Nyfeu/RISC-V/clockInfo.txt

-------------------------------------
| Tool Version : Vivado v.2025.2
| Date         : Sat Sep 12 03:04:39 2026
| Host         : pop-os
| Design       : design_1
| Device       : xc7a100t-csg324-1--
-------------------------------------

For more information on clockInfo.txt clock routing debug file see https://support.xilinx.com/s/article/000035660?language=en_US
