Nyfeu/RISC-V/pkg/README.md

# 📦 VHDL Packages

Arquivos de definição global.

- `riscv_isa_pkg.vhd`: Definições do ISA RISC-V (Opcodes, Funct3, Funct7, Tipos de dados da ALU).
