Nyfeu/RISC-V/docs/main.tex

% Modelo de monografia criado para a Escola de Engenharia Mauá
% do Instituto Mauá de Tecnolgoia a partir da classe abntex2.
% Este documento só deverá ser alterado para incluir ou excluir
% elementos pré e pós textuais. Use o comentário do latex (%) caso
% deseje excluir algum elemento.

% --------------------------------------------------------------------------
% Definindo ABNTeX2
% --------------------------------------------------------------------------

\documentclass[
	12pt,				% tamanho da fonte
	openright,			% capítulos começam em pág ímpar
	twoside,			% para impressão em frente e verso. Oposto a oneside
	a4paper,			% tamanho do papel.
	chapter=TITLE,		% títulos de capítulos convertidos em letras maiúsculas
	english,			% idioma adicional para hifenização
	brazil				% o último idioma é o principal do documento
	]{abntex2}
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
\usepackage[
	inner=3cm, outer=2cm, top=3cm, 
	bottom=2cm
]{geometry}
\usepackage[final]{pdfpages}
\usepackage{longtable}
\usepackage{booktabs}
\usepackage{xltabular}
\usepackage{placeins}

\newcolumntype{L}{>{\RaggedRight\arraybackslash}X}
\pdfstringdefDisableCommands{%
  \renewcommand{\uppercase}[1]{#1}%
}
		
% --------------------------------------------------------------------------
% Pacotes adicionais, retirar posteriormente
% --------------------------------------------------------------------------

\usepackage{lipsum}				% para geração de dummy text

% --------------------------------------------------------------------------
% Pacotes de citações
% --------------------------------------------------------------------------

\usepackage[alf, abnt-emphasize=bf]{abntex2cite}	% Citações padrão ABNT

% --------------------------------------------------------------------------
% Customizações para o layout do IMT
% --------------------------------------------------------------------------

\usepackage{modelo-maua/maua}

% Muda o título de lista de ilustrações para lista de figuras
\addto\captionsbrazil{%
  \renewcommand{\listfigurename}%
    {Lista de Ilustrações}%
	\renewcommand{\listtablename}%
    {Lista de Tabelas}%
}

% Permite utilizar figuras sem precisar colocar o caminho absoluto
\graphicspath{{imagens/}}

% Define o ambiente de experimentos
\theoremstyle{definition}
\newtheorem{experimento}{Experimento}[section]
\newcommand{\experimentoautorefname}{Experimento}

% --------------------------------------------------------------------------
% Informações de dados para CAPA e FOLHA DE ROSTO
% --------------------------------------------------------------------------

\universidade{CENTRO UNIVERSITÁRIO DO INSTITUTO MAUÁ DE TECNOLOGIA}
\faculdade{ESCOLA DE ENGENHARIA MAUÁ}
\curso{ENGENHARIA DE COMPUTAÇÃO}
\titulo{PROJETO E ANÁLISE DE UM SOC RISC-V COM ACELERAÇÃO NEURAL EM FPGA}
\autor{
	André Solano Ferreira Rodrigues Maiolini\\
	Durval Consorti Soranz de Barros Santos\\
	Leonardo Roberto Amadio\\
	Estevan Delazari Feher\\
	Lucas Castanho Paganotto
}
\local{SÃO PAULO}
\data{2026}
\orientador{Prof. Me. Nuncio Perrella}
\preambulo{Trabalho de conclusão de curso apresentado como requisito parcial para obtenção do título de Engenheiro de Computação, abordando o projeto, implementação e análise de desempenho de um System-on-Chip (SoC) baseado na arquitetura RISC-V com suporte à computação heterogênea.}

% --------------------------------------------------------------------------
% Configurações de aparência do PDF final
% --------------------------------------------------------------------------

% alterando o aspecto da cor azul
\definecolor{blue}{RGB}{41,5,195}

% informações do PDF
\makeatletter
\hypersetup{
     	%pagebackref=true,
		pdftitle={\imprimirtitulo}, 
		pdfauthor={\imprimirautor},
    	pdfsubject={\imprimirpreambulo},
	    pdfcreator={LaTeX with abnTeX2},
		pdfkeywords={\imprimirpalavraschave}, 
		colorlinks=true,       		% false: boxed links; true: colored links
    	linkcolor=black,          	% color of internal links
    	citecolor=black,        		% color of links to bibliography
    	filecolor=magenta,      		% color of file links
		urlcolor=blue,
		bookmarksdepth=4,
        breaklinks=true
}
\makeatother

% --------------------------------------------------------------------------
% Espaçamentos entre linhas e parágrafos 
% --------------------------------------------------------------------------

% O tamanho do parágrafo é dado por:
\setlength{\parindent}{1.3cm}

% Controle do espaçamento entre um parágrafo e outro:
\setlength{\parskip}{0pt}  

% --------------------------------------------------------------------------
% Compila o indice
% --------------------------------------------------------------------------

\makeindex

% --------------------------------------------------------------------------
% Início do documento
% --------------------------------------------------------------------------

\begin{document}

% Seleciona o idioma do documento (conforme pacotes do babel)
%\selectlanguage{english}
\selectlanguage{brazil}

% Espaçamento entre linhas 1.5
\OnehalfSpacing

% Retira espaço extra obsoleto entre as frases.
\frenchspacing 

% ----------------------------------------------------------
% ELEMENTOS PRÉ-TEXTUAIS
% ----------------------------------------------------------

\input{elementos-pre-textuais/pretextuais}

% ----------------------------------------------------------
% ELEMENTOS TEXTUAIS
% ----------------------------------------------------------

\textual

% ----------------------------------------------------------
% Introdução
% ----------------------------------------------------------

\input{elementos-textuais/introdução}

% ----------------------------------------------------------
% Revisão da Literatura
% ----------------------------------------------------------

\input{elementos-textuais/revisao_bibliografica.tex}

% ----------------------------------------------------------
% Desenvolvimento
% ----------------------------------------------------------

\input{elementos-textuais/desenvolvimento}

% ----------------------------------------------------------
% Resultados e Discussão
% ----------------------------------------------------------

\input{elementos-textuais/resultados_discussao}

% ----------------------------------------------------------
% Considerações Finais
% ----------------------------------------------------------

\input{elementos-textuais/conclusoes}

% ----------------------------------------------------------
% ELEMENTOS PÓS-TEXTUAIS
% ----------------------------------------------------------

\input{elementos-pos-textuais/pos-textual}
\end{document}
