Nyfeu/RISC-V/docs/elementos-pre-textuais/listas.tex

% --------------------------------------------------------------------------
% Inserir lista de ilustrações
% --------------------------------------------------------------------------

\pdfbookmark[0]{\listfigurename}{lof}
\listoffigures*
\cleardoublepage

% --------------------------------------------------------------------------
% Inserir lista de quadros
% --------------------------------------------------------------------------
\pdfbookmark[0]{\listofquadrosname}{loq}
\listofquadros*
\cleardoublepage

% --------------------------------------------------------------------------
% Inserir lista de tabelas
% --------------------------------------------------------------------------
\pdfbookmark[0]{\listtablename}{lot}
\listoftables*
\cleardoublepage

% --------------------------------------------------------------------------
% Inserir lista de algoritmos
% --------------------------------------------------------------------------
\pdfbookmark[0]{\listalgorithmcfname}{loa}
\imprimirlistadealgoritmos
\cleardoublepage

% --------------------------------------------------------------------------
% Inserir lista de abreviaturas e siglas
% --------------------------------------------------------------------------
\begin{siglas}
	\item[ABNT] Associação Brasileira de Normas Técnicas
  \item[abnTeX] ABsurdas Normas para TeX
\end{siglas}

% --------------------------------------------------------------------------
% Inserir lista de símbolos
% --------------------------------------------------------------------------
\begin{simbolos}
	\item[$ \Gamma $] Letra grega Gama
  \item[$ \Lambda $] Lambda
  \item[$ \zeta $] Letra grega minúscula zeta
  \item[$ \in $] Pertence
\end{simbolos}

% --------------------------------------------------------------------------
% Inserir o sumario
% --------------------------------------------------------------------------
\pdfbookmark[0]{\contentsname}{toc}
\tableofcontents*
\cleardoublepage
