Nyfeu/RISC-V/docs/imagens/internal_vs_external_buses.jpg

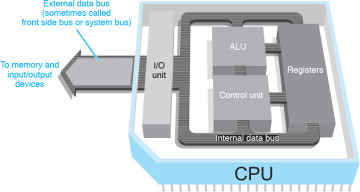
docs/imagens/internal_vs_external_buses.jpg
