Nyfeu/RISC-V/docs/imagens/estrutura_dna-eps-converted-to.pdf

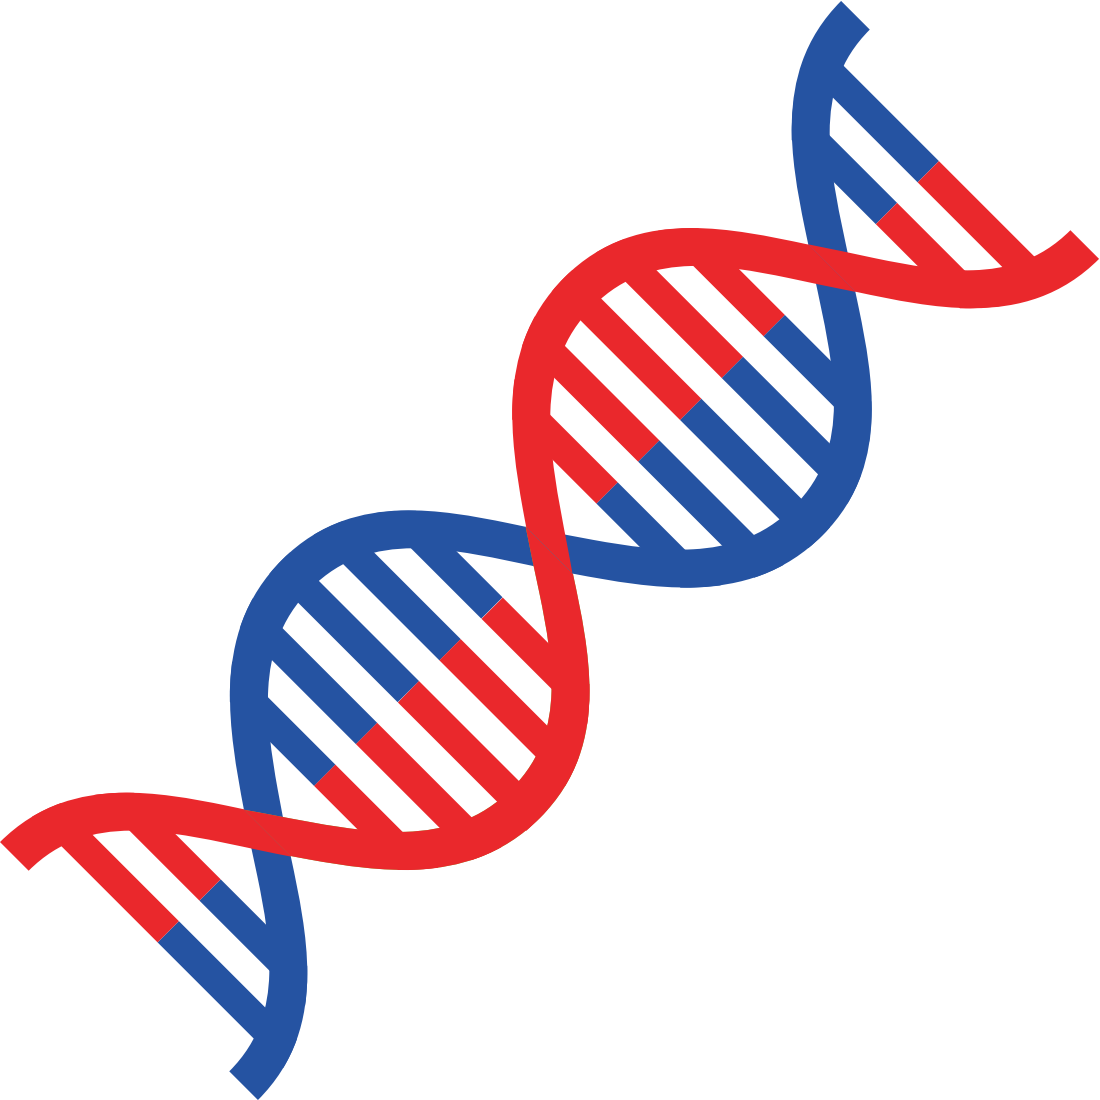
[picture p6: page 1]
