Nyfeu/RISC-V/docs/imagens/gold_bacterial_sequencing_status-eps-converted-to.pdf

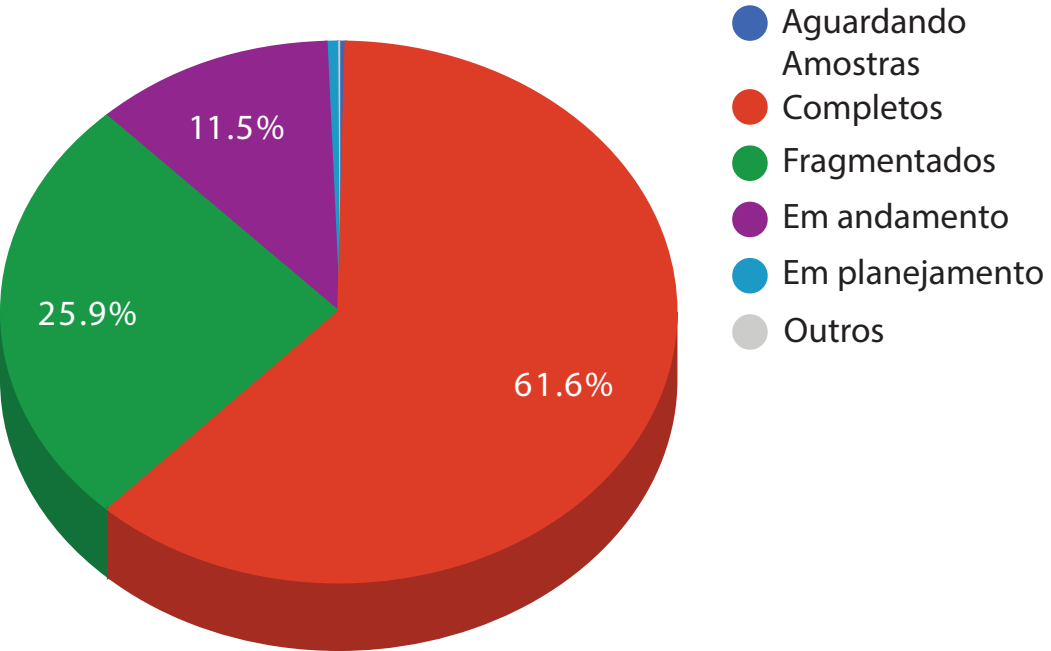
[picture p7: page 1]
Em andamento; Em planejamento; Outros; Fragmentados; Completos; Aguardando Amostras
