Nyfeu/RISC-V/rtl/perips/gpio/gpio_controller.vhd

----------------------------------------------------------------------------------
-- 
-- File: gpio_controller.vhd
--
--  ██████╗ ██████╗ ██╗ ██████╗ 
-- ██╔════╝ ██╔══██╗██║██╔═══██╗
-- ██║  ███╗██████╔╝██║██║   ██║
-- ██║   ██║██╔═══╝ ██║██║   ██║
-- ╚██████╔╝██║     ██║╚██████╔╝
--  ╚═════╝ ╚═╝     ╚═╝ ╚═════╝ 
--                          
-- Descrição : Controlador simples de GPIO (LEDs e Switches)
-- 
-- Autor     : [André Maiolini]
-- Data      : [31/12/2025]    
--
------------------------------------------------------------------------------------------------------------------

library ieee;
use ieee.std_logic_1164.all;
use ieee.numeric_std.all;

-------------------------------------------------------------------------------------------------------------------
-- ENTIDADE: Definição da interface do Controlador de GPIO
-------------------------------------------------------------------------------------------------------------------

entity gpio_controller is
    port (
        clk         : in  std_logic;
        rst         : in  std_logic;
        
        -- Interface do Barramento
        vld_i       : in  std_logic;                      -- Chip Select (Ativo quando endereço é 0x2...)
        we_i        : in  std_logic;                      -- Write Enable
        addr_i      : in  std_logic_vector( 3 downto 0);  -- Offset do endereço
        data_i      : in  std_logic_vector(31 downto 0);
        data_o      : out std_logic_vector(31 downto 0);
        rdy_o       : out std_logic;
        
        -- Pinos Externos
        gpio_leds   : out std_logic_vector(15 downto 0);
        gpio_sw     : in  std_logic_vector(15 downto 0)
    );
end entity;

-------------------------------------------------------------------------------------------------------------------
-- ARQUITETURA: Implementação do Controlador de GPIO
-------------------------------------------------------------------------------------------------------------------

architecture rtl of gpio_controller is

    signal r_leds : std_logic_vector(15 downto 0);
    signal r_rdy  : std_logic := '0'; 

begin
    
    -- Conexões Físicas e Contínuas -------------------------------------------------------------------------------

    gpio_leds <= r_leds;
    rdy_o     <= r_rdy;

    -- Processo de Acesso (CPU <-> GPIO) --------------------------------------------------------------------------
    
    process(clk)
    begin

        if rising_edge(clk) then

            if rst = '1' then

                r_leds <= (others => '0');
                r_rdy  <= '0';
                data_o <= (others => '0');
            
            else
            
                -- Default: Ready baixa no ciclo seguinte garantindo pulso de 1 clock
                r_rdy  <= '0';
                data_o <= (others => '0');

                -- EDGE GUARD: Só aceita transação se o vld estiver alto e AINDA não tivermos respondido
                if vld_i = '1' and r_rdy = '0' then
                    
                    -- Handshake: Resposta no próximo ciclo (Latência 1)
                    r_rdy <= '1';

                    -- ESCRITA
                    if we_i = '1' then
                        if unsigned(addr_i) = 0 then
                            r_leds <= data_i(15 downto 0);
                        end if;
                    
                    -- LEITURA
                    else
                        case to_integer(unsigned(addr_i)) is
                            when 0 => data_o(15 downto 0) <= r_leds;
                            when 4 => data_o(15 downto 0) <= gpio_sw;
                            when others => null;
                        end case;
                    end if;
                end if;
            end if;
        end if;
    end process;

    ---------------------------------------------------------------------------------------------------------------

end architecture; -- rtl

-------------------------------------------------------------------------------------------------------------------
