Nyfeu/RISC-V/rtl/soc/dual_port_ram.vhd

------------------------------------------------------------------------------------------------------------------
-- 
-- File: dual_port_ram.vhd
--
-- ██████╗  █████╗ ███╗   ███╗
-- ██╔══██╗██╔══██╗████╗ ████║
-- ██████╔╝███████║██╔████╔██║
-- ██╔══██╗██╔══██║██║╚██╔╝██║
-- ██║  ██║██║  ██║██║ ╚═╝ ██║
-- ╚═╝  ╚═╝╚═╝  ╚═╝╚═╝     ╚═╝
--  
-- Descrição : Módulo de RAM dual-port para leitura e escrita simultâneas
--    em duas portas independentes - usando BRAM inferida.
--    [ATUALIZADO: Edge Guard (r_rdy_a / r_rdy_b) para barramento atômico]
-- 
-- Autor     : [André Maiolini]
-- Data      : [30/12/2025]    
--
------------------------------------------------------------------------------------------------------------------

library ieee;
use ieee.std_logic_1164.all;
use ieee.numeric_std.all;

-------------------------------------------------------------------------------------------------------------------
-- ENTIDADE: Definição da interface da Dual Port RAM
-------------------------------------------------------------------------------------------------------------------

entity dual_port_ram is
    generic (
        ADDR_WIDTH : integer := 12; 
        DATA_WIDTH : integer := 32
    );
    port (
        clk        : in  std_logic;
        
        -- Porta A
        vld_a_i    : in  std_logic; 
        we_a       : in  std_logic_vector((DATA_WIDTH/8)-1 downto 0);
        addr_a     : in  std_logic_vector(ADDR_WIDTH-1 downto 0);
        data_a_i   : in  std_logic_vector(DATA_WIDTH-1 downto 0);
        data_a_o   : out std_logic_vector(DATA_WIDTH-1 downto 0);
        rdy_a_o    : out std_logic;
        
        -- Porta B
        vld_b_i    : in  std_logic;
        we_b       : in  std_logic_vector((DATA_WIDTH/8)-1 downto 0);
        addr_b     : in  std_logic_vector(ADDR_WIDTH-1 downto 0);
        data_b_i   : in  std_logic_vector(DATA_WIDTH-1 downto 0);
        data_b_o   : out std_logic_vector(DATA_WIDTH-1 downto 0);
        rdy_b_o    : out std_logic

    );
end entity;

-------------------------------------------------------------------------------------------------------------------
-- ARQUITETURA: Implementação da Dual Port RAM
-------------------------------------------------------------------------------------------------------------------

architecture rtl of dual_port_ram is

    -- Tipo de dado para a RAM
    type t_ram is array (0 to (2**ADDR_WIDTH)-1)
        of std_logic_vector(DATA_WIDTH-1 downto 0);

    -- Usar shared variable permite que múltiplos processos acessem a memória sem conflito.
    shared variable ram : t_ram := (others => (others => '0'));

    -- Atributo para forçar inferência de Block RAM 
    attribute ram_style : string;
    attribute ram_style of ram : variable is "block";

    -- Desabilita a otimização de cascata profunda que causa o erro de pino ADDR15.
    attribute cascade_height : integer;
    attribute cascade_height of ram : variable is 0;

    -- ====================================================================
    -- SINAIS DE GUARDA PARA O HANDSHAKE
    -- ====================================================================
    signal r_rdy_a : std_logic := '0';
    signal r_rdy_b : std_logic := '0';

begin

    -- Roteamento contínuo
    rdy_a_o <= r_rdy_a;
    rdy_b_o <= r_rdy_b;

    -- ============================================================================================================
    -- PORTA A
    -- ============================================================================================================
    process(clk)
    begin

        if rising_edge(clk) then

            -- Default: Remove o ACK para garantir que dure apenas 1 ciclo
            r_rdy_a <= '0';

            -- Edge Guard: Executa o acesso APENAS se tem pedido e ainda não respondemos
            if vld_a_i = '1' and r_rdy_a = '0' then
                
                r_rdy_a <= '1';
                
                -- Leitura (Read-First)
                data_a_o <= ram(to_integer(unsigned(addr_a)));
                
                -- Escrita controlada por byte enable
                for i in 0 to (DATA_WIDTH/8)-1 loop
                    if we_a(i) = '1' then
                        ram(to_integer(unsigned(addr_a)))(8*i+7 downto 8*i) := data_a_i(8*i+7 downto 8*i);
                    end if;
                end loop;
                
            end if;

        end if;
        
    end process;

    -- ============================================================================================================
    -- PORTA B
    -- ============================================================================================================
    process(clk)
    begin

        if rising_edge(clk) then

            -- Default: Remove o ACK para garantir que dure apenas 1 ciclo
            r_rdy_b <= '0';

            -- Edge Guard: Executa o acesso APENAS se tem pedido e ainda não respondemos
            if vld_b_i = '1' and r_rdy_b = '0' then
                
                r_rdy_b <= '1';
                
                -- Leitura (Read-First)
                data_b_o <= ram(to_integer(unsigned(addr_b)));
                
                -- Escrita controlada por byte enable
                for i in 0 to (DATA_WIDTH/8)-1 loop
                    if we_b(i) = '1' then
                        ram(to_integer(unsigned(addr_b)))(8*i+7 downto 8*i) := data_b_i(8*i+7 downto 8*i);
                    end if;
                end loop;
                
            end if;

        end if;

    end process;

end architecture;

-------------------------------------------------------------------------------------------------------------------
