Nyfeu/RISC-V/(commit log)

2025-09-15 fix: correct alu_control decoding
    [alu_control.vhd, control_unit.vhd, processor_top.vhd]
2025-09-23 refactor: turn off print debug
2025-11-28 fix: hex loading in memory
    [hello.c]
2025-11-30 fix: lui and auipc logic
    [control.vhd, datapath.vhd, decoder.vhd, processor_top.vhd]
2025-11-30 fix: blt and bge to sign logic
    [alu_control.vhd, branch_unit.vhd]
2025-11-30 fix: jumps JAL and JALR
    [datapath.vhd]
2025-12-17 fix: resolve unused signals
    [control.vhd, datapath.vhd]
2025-12-22 fix(ram): update dual_port_ram.vhd to use BRAM
    [dual_port_ram.vhd]
2025-12-22 feat(rtl): add uart_tx.vhd
2025-12-22 feat(rtl): add uart_rx.vhd
2025-12-22 feat(rtl): add uart_controller.vhd
2025-12-23 docs: update comments uart_controller
2025-12-26 refactor(rtl): replace load/store units with unified LSU in datapath
    [datapath.vhd]
2025-12-26 fix: remove test_processor.py from common
    [riscv_uarch_pkg.vhd]
2025-12-27 feat(rtl): add architectural registers to formalize datapath stages
2025-12-29 docs: update multicycle FSM schema to 5 execution stages
2025-12-31 fix(core): synchronous reset to resolve Vivado BRAM warning
    [datapath.vhd, main_fsm.vhd, processor_top.vhd]
2025-12-31 fix(fpga): set config voltage to fix warnings
    [pins.xdc]
2025-12-31 feat(bootloader): implement Fibonacci generator with UART output
2026-01-01 refactor(uart): unify TX/RX and fix timing synchronization issues
    [soc_top.vhd, uart_controller.vhd]
2026-01-01 feat(uart): implement 64 byte RX FIFO buffer
2026-01-05 docs(uart): update uart_controller comments
2026-01-05 fix: change vga_peripheral header
    [vga_peripheral.vhd]
2026-01-05 feat(sw): add hardware abstraction layer for UART
2026-01-17 feat(bus): implement fixed-priority preemptive bus arbiter
    [test_bus_arbiter.py]
2026-01-17 feat(dma): add dma controller peripheral
2026-01-17 refactor(bus): update interconnect for arbiter and dma support
2026-01-17 feat(soc): integrate dma and arbiter into soc_top
2026-01-17 fix(npu-sw): remove double-read software workarounds
    [memory_wrapper.vhd]
2026-01-17 feat(hal): implement dma hardware abstraction layer
2026-01-17 test(sw): add dma verification application
2026-01-18 fix(soc): prevent double-write race condition in bus arbiter
    [dma_controller.vhd, test_bus_arbiter.py]
2026-01-18 fix(perips): enforce synchronous MMIO handshake
    [gpio_controller.vhd, uart_controller.vhd, vga_peripheral.vhd]
2026-01-18 fix(timing): resolve critical path violation in branch instruction
    [control.vhd, main_fsm.vhd]
2026-01-19 fix(core): add missing signal to sensitivity list in main_fsm
    [main_fsm.vhd]
2026-01-24 feat(rtl): add timer MMIO
2026-01-24 feat(sw): add software to support timer
2026-01-29 feat(core): implement full interrupt support (Timer/External/Soft)
2026-01-29 test(cocotb): add interruption simulation test
2026-01-29 fix(cocotb): change log info
    [test_irq.c]
2026-01-29 fix(soc): wire up new processor interrupt ports in top-level
    [soc_top.vhd]
2026-01-31 fix(core): enforce Zicsr compliance and robust exception handling
    [csr_file.vhd]
2026-01-31 fix(core): resolve rs2 aliasing in CSR instructions and add atomic RMW logic
    [csr_file.vhd, datapath.vhd]
2026-01-31 feat(soc): add Core Local Interruptor (CLINT) for timer and sw interrupts
2026-01-31 test(clint): add verification suite for interrupts on sim and fpga
2026-01-31 chore(apps): update applications to use new timer HAL
2026-01-31 chore(apps): remove clint_test workaround
    [clint_test.c]
2026-02-01 feat(rtl): add PLIC for external interrupt requests
2026-02-01 feat(rtl): add irq to DMA
2026-02-01 feat(sw): use npu interrupt in npu_server
2026-09-12 docs(mkdocs): index all pages in docs/ and fix broken references
    - Add missing pages to nav: barramento, memoria_dma, debug_controller,
    toolchain/build system and apps/servidores IA
    - Fix Aplicações paths (apps/ -> software/) and drop entries for pages
    that don't exist (quickstart, simulation, pong, fractal)
    - Group GPIO/UART/VGA/Debug under Periféricos
    - Rename space-named docs to snake_case
    - Fix mathjax.js path (javascripts/ -> javascript/)
    - Replace dead anchor to nonexistent CSR section in memoria_dma.md
2026-09-12 chore(merge): firmware, NPU, timing e documentação MkDocs (#32)
    * refactor: update bootloader
    * feat(mlp): add mlp inference system
    * feat(mlp): add mlp benchmark
    * feat(mlp): real-time edge ai inference
    * feat(mlp): add led gpio
    * feat(cnn): add conv2d nn technique
    * feat(bench): add new benchmark methodology
    * feat(rtl): optimize bus_arbiter FSM architecture
    * feat(rtl): optimize dma_controller fsm
    * feat(bench): update benchmark plot
    * feat(bench): add inflection point detection
    * chore: remove older benchmarks
    * feat(noc): migrate interconnect from shared bus to crossbar
    * feat(dma): decouple dma write and read
    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
2026-09-12 fix(ci): corrige testes de regressao
    [datapath_wrapper.vhd, test_bus_interconnect.py]
2026-09-12 fix: corrige vazamento de estado
    [test_dual_port_ram.py]
2026-09-12 fix: adiciona gerenciamento de submodulo
2026-09-12 fix: atualiza teste de compliance
2026-09-12 fix(sw): restaura cnn_server funcional
    Traz de volta o cnn_server.c do commit 28c66ac (branch feature/firmware).
    A versão atual travava na primeira inferência (0xFF) na placa; a restaurada
    gera o mesmo binário usado pela GUI e foi validada em hardware.
    [cnn_server.c]
